TheDIYGuy999/MRSC_Adapter_WLtoys_5Pin_Servo/(threads)

Thread 1 (2018-05-27):

Setting the correct gain

milanico2309, 2018-05-27:
Hi,

at first let me thank you for sharing this project. i succefully implemented it in my a959 setup. My last problem is, that i can't find the correct gain setting. i tried your default 20, but also 5, 1, 0.1 and 0.01. The Systems is still too nervous so my car does wobbly lines when i wan't to go straight. It's like the Camaro in your other video. (https://www.youtube.com/watch?v=IPve7QpdLBc)

What can i do to fix this?

M

TheDIYGuy999, 2018-05-28:
You're welcome. The wobble may be caused by too much backlash in your steering mechanism. Are the resistor and capacitor values identical with my setup? Otherwise the reaction speed of the output signal may be wrong and cause wobble.

milanico2309, 2018-05-29:
Yes, i checked the specs. of the filter-components again. The values are as specified. I fiddelt around with the code and noticed something. If i do ` int turnRateMeasured = (yaw_rate * 127) * 0.3;` istead of ` int turnRateMeasured = (yaw_rate * 127) * mrscGain/100;` with a gain of 30, it works. so it may be a datatype problem screwing up the calculation. (because turnRateMeasured is an integer, so the diversion alway returns full numbers e.g. 1 or 0)

TheDIYGuy999, 2018-05-29:
Strange, but indeed, an overflow could occur, depending on your gain.
try: long turnRateMeasured = (yaw_rate * 127) * mrscGain / 100;
My current gain is 15 BTW.

owerlordalex, 2020-04-08:
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
It's working great! Thank you

Thread 2 (2018-05-29):

startup delay

bluespider42, 2018-05-29:
I have followed the instructions given but I have been having a problem and wondered if you had any thoughts.
There seems to be a ~1.5 second delay between turning on the system and the output voltage from the arduino to the ESC stabilising. this means that the receiver tries to turn the servo too far before the feedback to the esc gets to the correct voltage.
When the arduino is not connected to the servo the output voltage settles within ~35ms of power on.
I have checked the values of both the resistor and capacitor (and experimented with different values).

ustolt, 2019-09-20:
The start delay of about 1.46 seconds is caused by the Arduino Pro Mini  bootloader.

If you flash the optiboot / optiboot_atmega328.hex (https://github.com/Optiboot/optiboot/blob/master/optiboot/bootloaders/optiboot/optiboot_atmega328.hex), you get a boot time of about 68ms.

The blue line shows VCC, the yellow, the output of A10.

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

owerlordalex, 2020-04-07:
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

owerlordalex, 2020-04-07:
when compiling, it displays an error

owerlordalex, 2020-04-07:
please help

owerlordalex, 2020-04-07:
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

TheDIYGuy999, 2020-04-07:
Install PWMFrequency library

owerlordalex, 2020-04-07:
can you please have a detailed video instruction on the firmware? I am from Russia and not strong in English

owerlordalex, 2020-04-07:
sorry. really want to repeat your project

TheDIYGuy999, 2020-04-07:
Sorry, I can't. Have a close look at the pictures for the wiring and use google translator for the comments in the sketch.

owerlordalex, 2020-04-07:
I'll figure it out myself ...

owerlordalex, 2020-04-07:
thanks

Closed 2020-04-07.
